eewiki/24V_LED_Motor_Simulator-/Motor Simulator 24V, NOV2025.gif

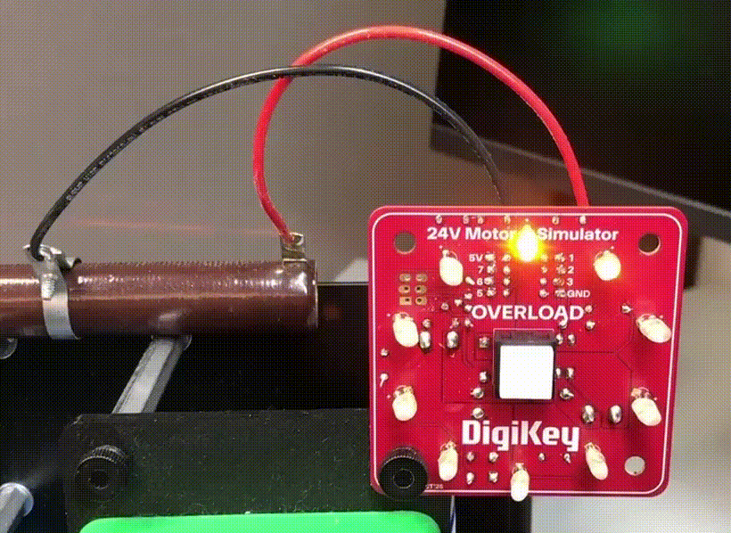
Motor Simulator 24V, NOV2025.gif
