eewiki/24V_LED_Motor_Simulator-/Schematic.png

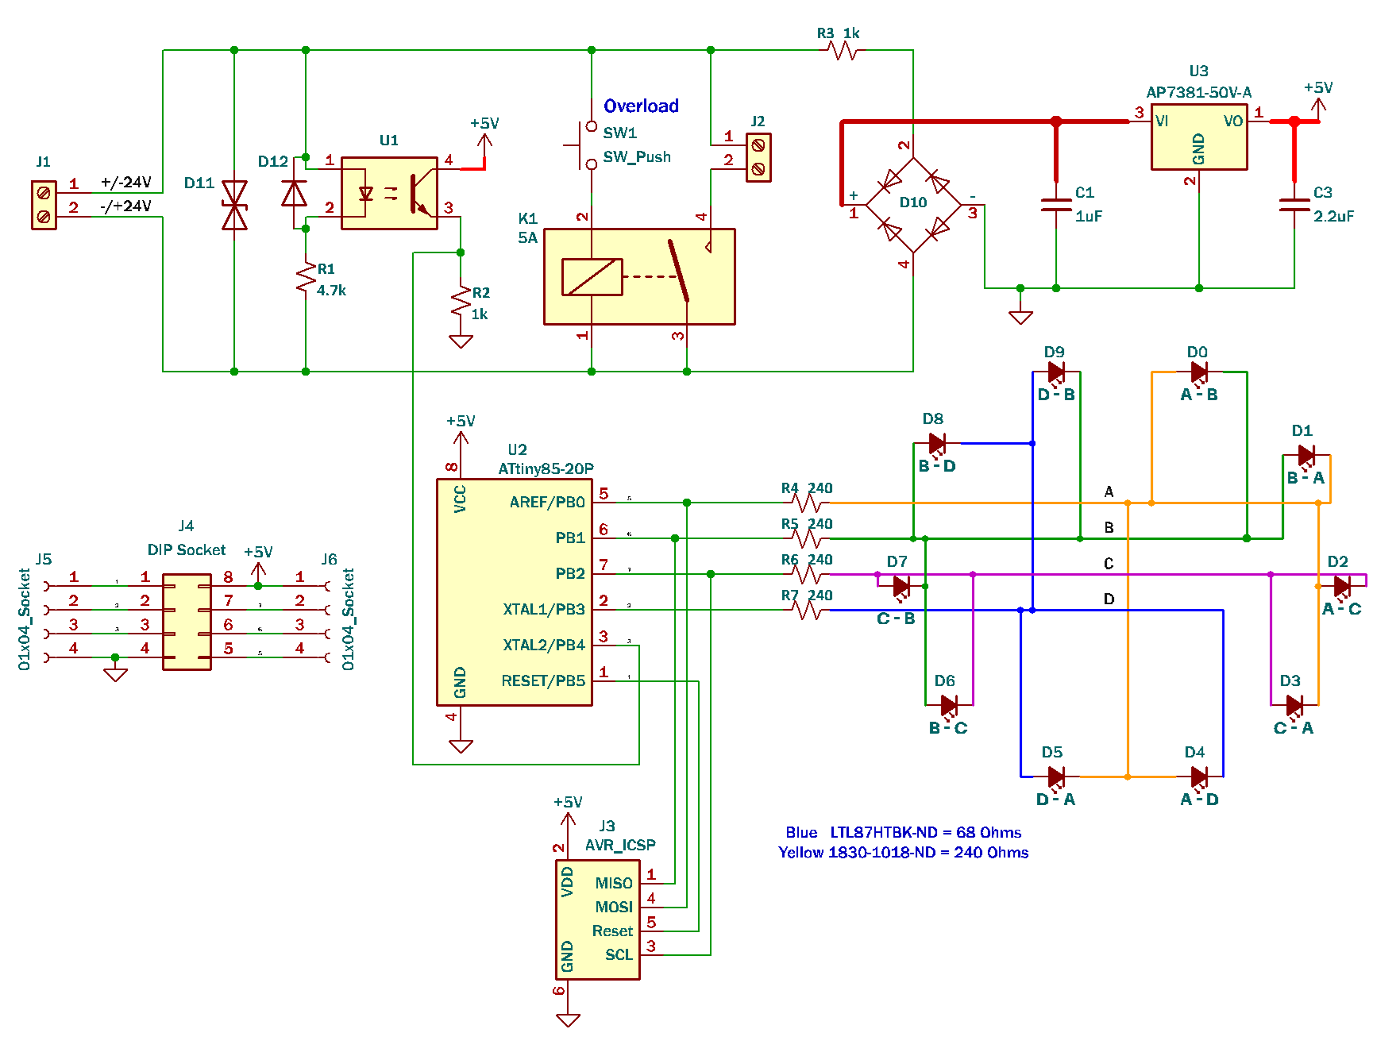
Schematic.png
