eewiki/24V_LED_Motor_Simulator-/Motor Simulator 24V, BOM.xlsx

Reference | Value | Qty | Part Number | x4
D11 | D_TVS | 1 | 13-P4KE30CA/BCT-ND | 4
D12 | 1N4148 | 1 | 1N4148FS-ND | 4
D0 - D9 | Yellow, 5mm, Diffused | 10 | 1830-1018-ND | 40
J1,J2 | Screw_Terminal_01x02 | 2 | 1818-QT02ASB83H0000G-ND | 8
J4 | DIP Socket | 1 | 2057-ICS-308-T-ND | 4
J5,J6 | 01x04_Socket | 2 | 2057-RS1-04-G-ND | 8
K1 | 5A | 1 | 2449-J1131AS24VDC.20-ND | 4
SW1 | SW_Push | 1 | 2449-NCA1-ND | 4
U1 | Optocoupler | 1 | 31-DPC817D-C-TU-ND | 4
C3 | 2.2uF | 1 | 445-173138-1-ND | 4
C1 | 1uF | 1 | 445-173257-1-ND | 4
D10 | B80R | 1 | 4878-B80R-ND | 4
U3 | AP7381-50V-A | 1 | AP7381-50V-ADICT-ND | 4
U2 | ATtiny85-20P | 1 | ATTINY85-20PU-ND | 4
R1 | 4.7k | 1 | CFM14JA4K70CT-ND | 4
R2,R3 | 1k | 2 | S1KQCT-ND | 8
R4 - R7 | 240 Ohm, 1/4W, Axial | 4 | 738-CFM14JA240RCT-ND | 16
D0 - D9 | Blue, 3mm | 10 | LTL87HTBK-ND | 40
R4 - R7 | 68 Ohm, 1/4W, Axial | 4 | 738-CFM14JA68R0CT-ND | 16
