eewiki/24V_LED_Motor_Simulator-/KiCad_Files/Motor Simulator 24V, NOV2025.kicad_pcb

## KiCad design KiCad_Files/Motor Simulator 24V, NOV2025.kicad_pcb (2025-12-29)

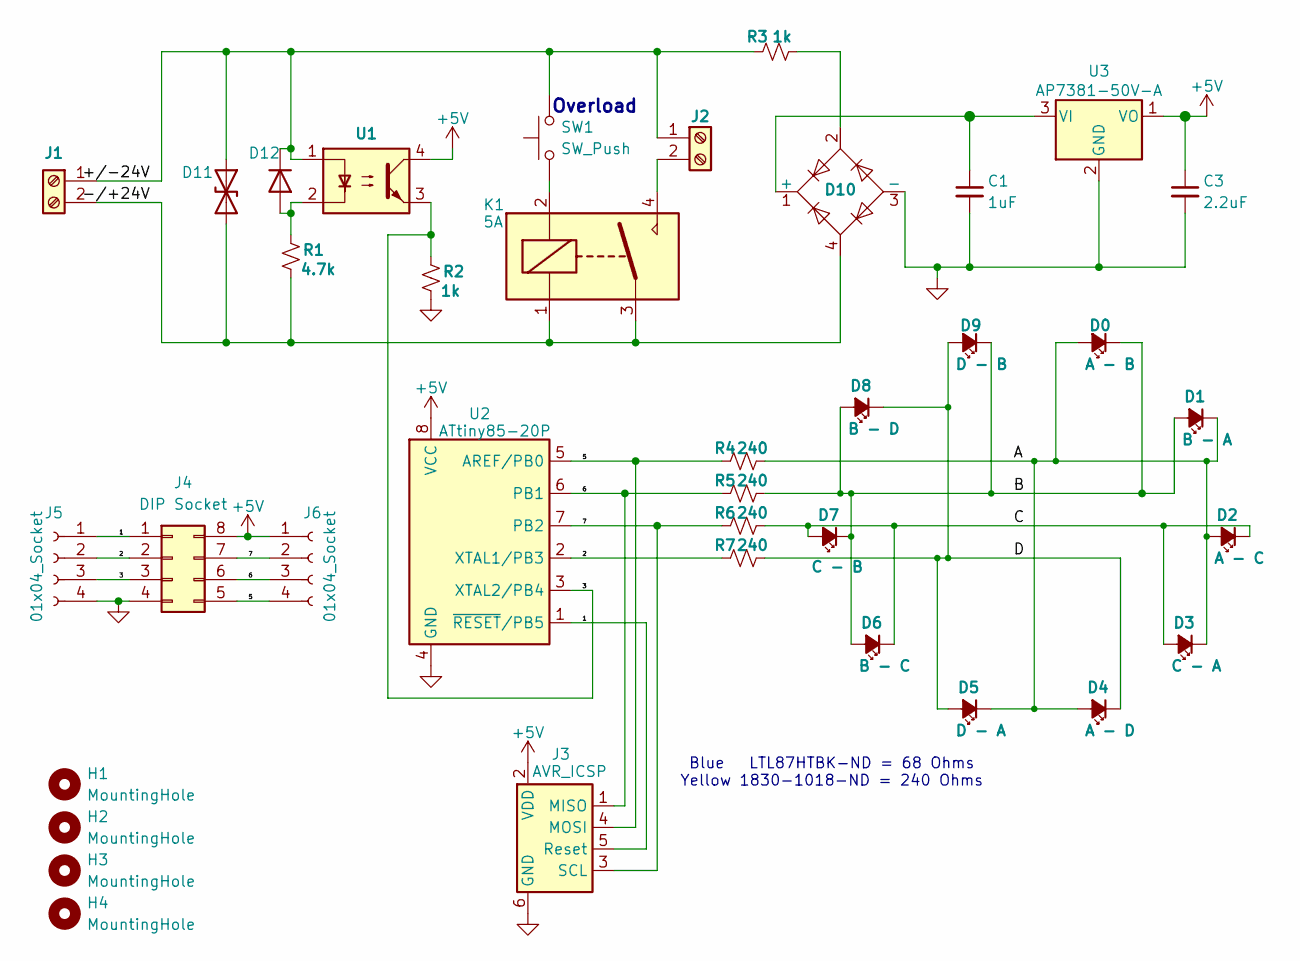
[picture p3: schematic Motor Simulator 24V, NOV2025.kicad_sch, 24V Motor Simulator with Overload]

Parts:
C1: 1uF; C_Disc_D3.0mm_W1.6mm_P2.50mm
C3: 2.2uF; C_Disc_D3.0mm_W1.6mm_P2.50mm
D0: A - B; LED_D3.0mm
D1: B - A; LED_D3.0mm
D2: A - C; LED_D3.0mm
D3: C - A; LED_D3.0mm
D4: A - D; LED_D3.0mm
D5: D - A; LED_D3.0mm
D6: B - C; LED_D3.0mm
D7: C - B; LED_D3.0mm
D8: B - D; LED_D3.0mm
D9: D - B; LED_D3.0mm
D10: B80R; Diode_Bridge_Round_D9.0mm
D11: D_TVS; D_DO-41_SOD81_P7.62mm_Horizontal
D12: 1N4148; D_DO-35_SOD27_P7.62mm_Horizontal
H1, H2, H3, H4: MountingHole; MountingHole_4.4mm_#8
J1, J2: Screw_Terminal_01x02; TermBlock_Lever_1818-QT02ASB83H0000G-ND
J3: AVR_ICSP; PinHeader_2x03_P2.54mm_Vertical
J4: DIP Socket
J5: 01x04_Socket; PinSocket_1x04_P2.54mm_Vertical_Staggered_Left
J6: 01x04_Socket; PinSocket_1x04_P2.54mm_Vertical_Staggered_Right
K1: 5A; Relay_J113__SPST
R1: 4.7k; R_Axial_DIN0204_L3.6mm_D1.6mm_P5.08mm_Horizontal
R2, R3: 1k; R_Axial_DIN0204_L3.6mm_D1.6mm_P5.08mm_Horizontal
R4, R5, R6, R7: 240; R_Axial_DIN0204_L3.6mm_D1.6mm_P5.08mm_Horizontal
SW1: SW_Push; SW_NCA2
U1: Optocoupler_DC_PhotoNPN_AKEC; DIP-4_W7.62mm_LongPads
U2: ATtiny85-20P; DIP-8_W7.62mm
U3: AP7381-50V-A; TO-92_HandSolder

Connections:
+5V: C3.1, J3.2 (VDD), J4.8, J6.1, U1.4, U2.8 (VCC), U3.1 (VO)
/1: J3.5 (Reset), J4.1, J5.1, U2.1 (~RESET/PB5)
/2: J4.2, J5.2, R7.1, U2.2 (XTAL1/PB3)
/3: J4.3, J5.3, R2.1, U1.3, U2.3 (XTAL2/PB4)
/5: J3.4 (MOSI), J4.5, J6.4, R4.1, U2.5 (AREF/PB0)
/6: J3.1 (MISO), J4.6, J6.3, R5.1, U2.6 (PB1)
/7: J3.3 (SCL), J4.7, J6.2, R6.1, U2.7 (PB2)
/22.6V_(24V_-_0.7V_x_2): C1.1, D10.1 (+), U3.3 (VI)
/+/-24V: D11.1 (A1), D12.1 (K), J1.1, J2.1, R3.1, SW1.2, U1.1
/-/+24V: D10.4, D11.2 (A2), J1.2, K1.1, K1.3, R1.2
GND: C1.2, C3.2, D10.3 (-), J3.6 (GND), J4.4, J5.4, R2.2, U2.4 (GND), U3.2 (GND)
unnamed: D0.2 (A), D1.1 (K), D2.2 (A), D3.1 (K), D4.2 (A), D5.1 (K), R4.2
unnamed: D0.1 (K), D1.2 (A), D6.2 (A), D7.1 (K), D8.2 (A), D9.1 (K), R5.2
unnamed: D2.1 (K), D3.2 (A), D6.1 (K), D7.2 (A), R6.2
unnamed: D4.1 (K), D5.2 (A), D8.1 (K), D9.2 (A), R7.2
unnamed: D10.2, R3.2
unnamed: D12.2 (A), R1.1, U1.2
unnamed: J2.2, K1.4
unnamed: K1.2, SW1.1

Notes on the sheet:
Blue LTL87HTBK-ND = 68 Ohms Yellow 1830-1018-ND = 240 Ohms
Overload

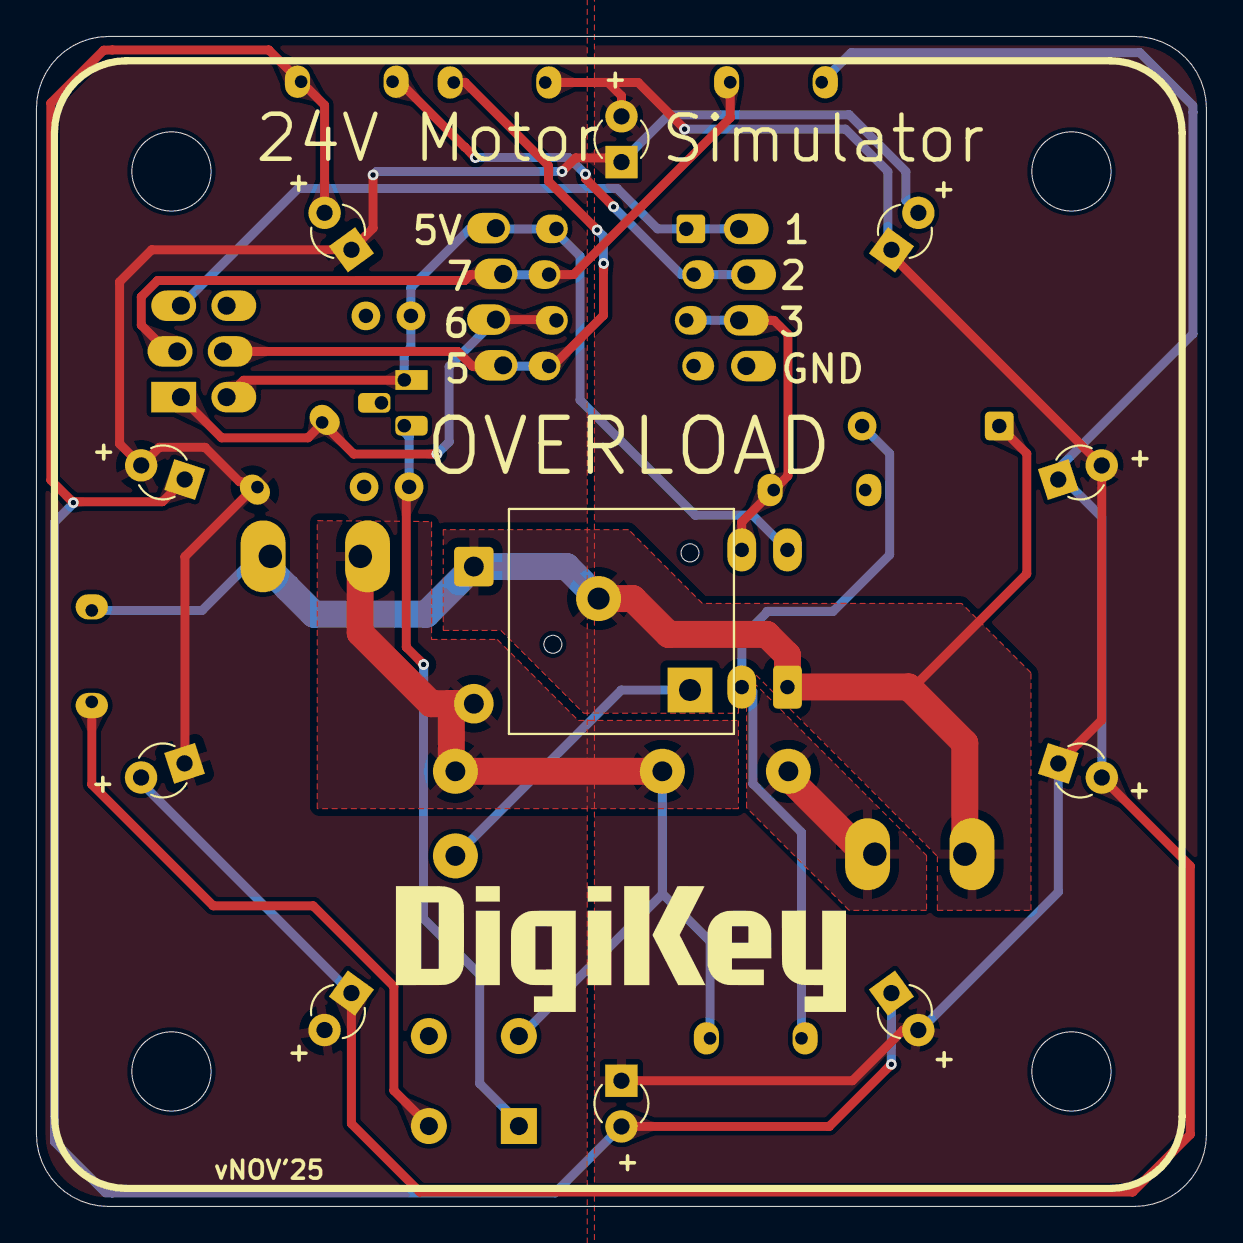
[picture p4: board Motor Simulator 24V, NOV2025.kicad_pcb from above]

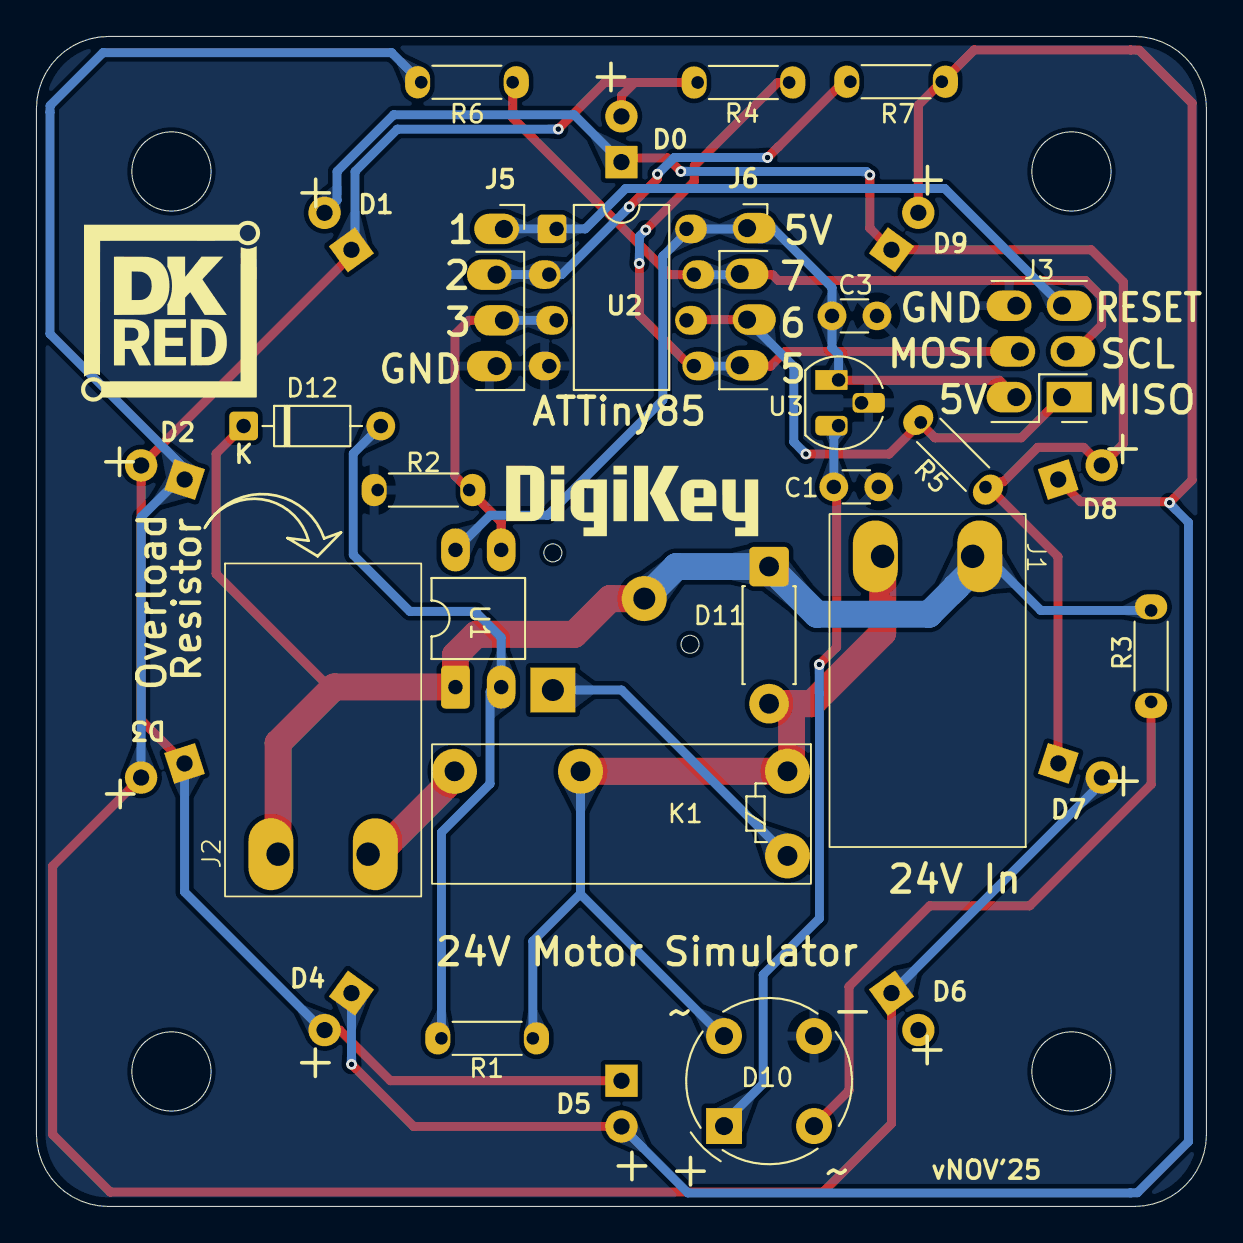
[picture p5: board Motor Simulator 24V, NOV2025.kicad_pcb from below]

Board: 2 copper layers, 65.0 x 65.0 mm, 37 parts (21 on the bottom side), 19 nets.

Other parts of the board:
G1: LOGO
